gkim65/L46_sim2Real/Photos_Hardware/KakaoTalk_Photo_2024-01-17-17-17-41 014.jpeg

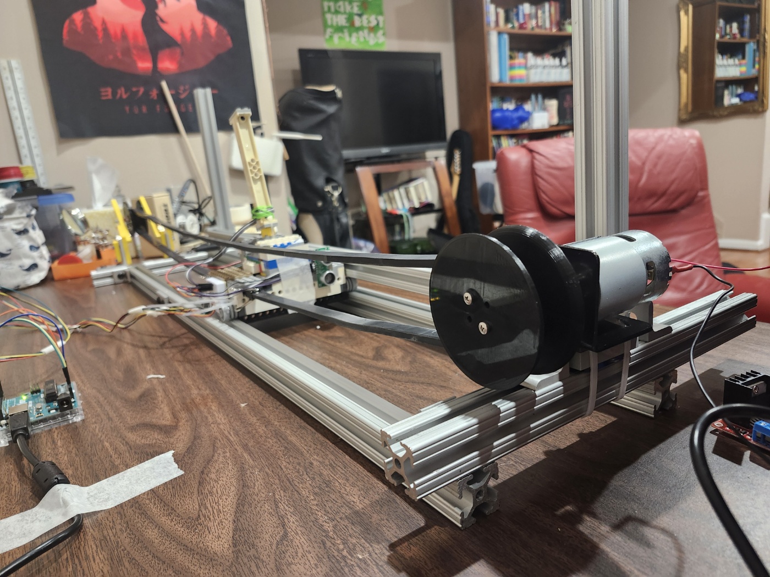
Photos_Hardware/KakaoTalk_Photo_2024-01-17-17-17-41 014.jpeg
