gkim65/L46_sim2Real/Photos_Hardware/pendulum_closeup2.jpeg

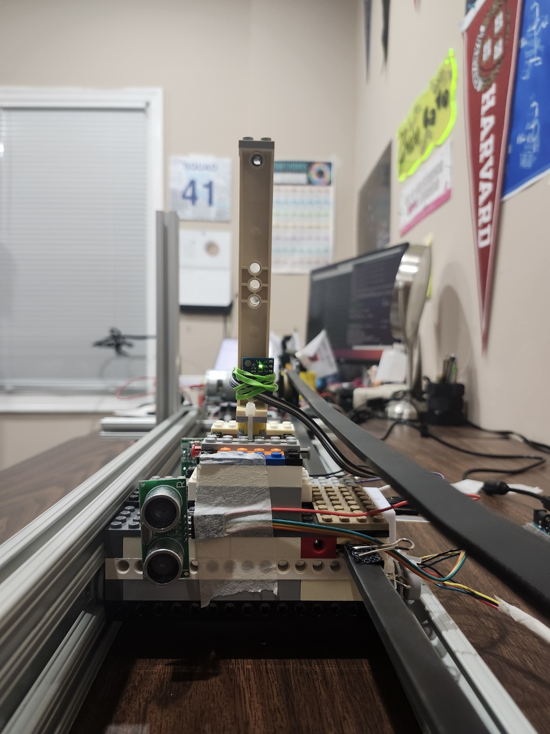
Photos_Hardware/pendulum_closeup2.jpeg
