gkim65/L46_sim2Real/Photos_Hardware/Other misc. photos of the setup/Computing Units/KakaoTalk_Photo_2024-01-17-17-17-34 006.jpeg

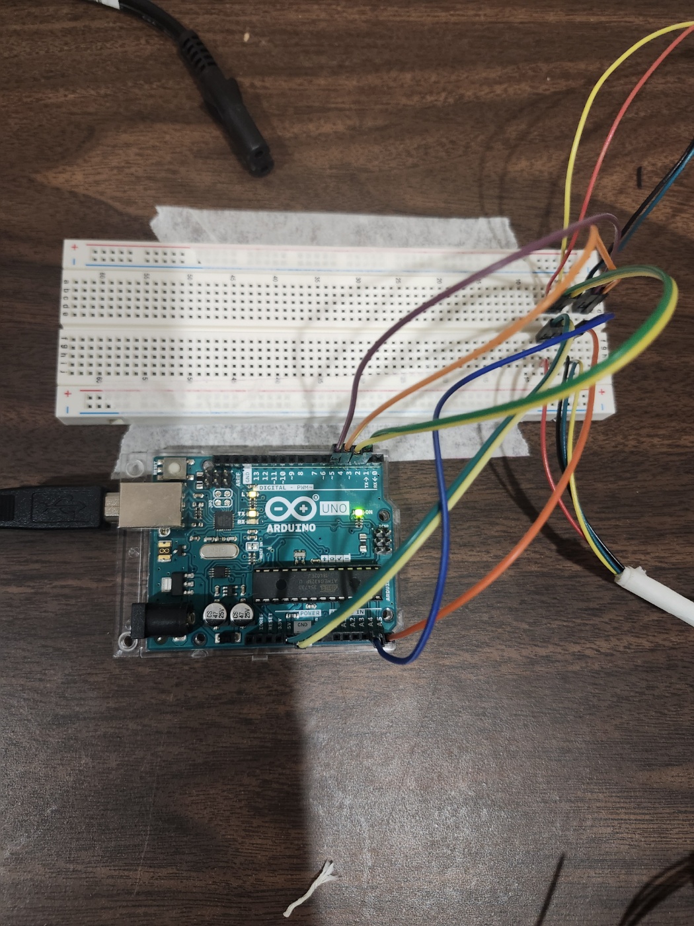
Photos_Hardware/Other misc. photos of the setup/Computing Units/KakaoTalk_Photo_2024-01-17-17-17-34 006.jpeg
