gkim65/L46_sim2Real/Photos_Hardware/Other misc. photos of the setup/KakaoTalk_Photo_2024-01-17-17-17-38 009.jpeg

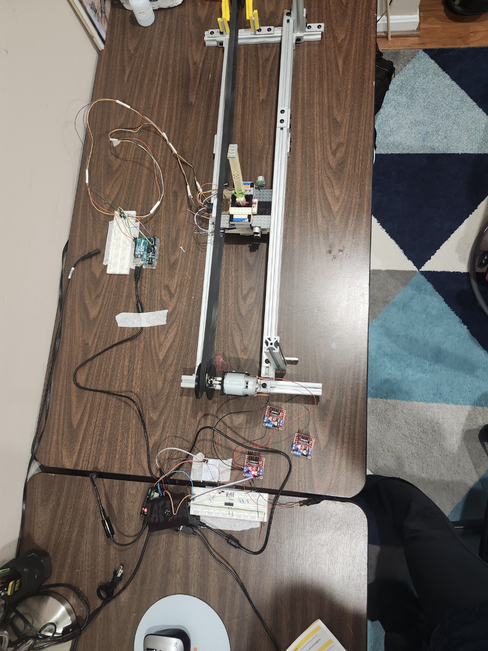
Photos_Hardware/Other misc. photos of the setup/KakaoTalk_Photo_2024-01-17-17-17-38 009.jpeg
