gkim65/L46_sim2Real/(commit log)

2024-01-11 raspberry pi practice files sensors
2024-01-11 arduino code
2024-01-11 code is starting to work rpi and arduino together
2024-01-11 edits to arduino code
